rosie-projects/dtmr_tupy/ROS DTMR.png

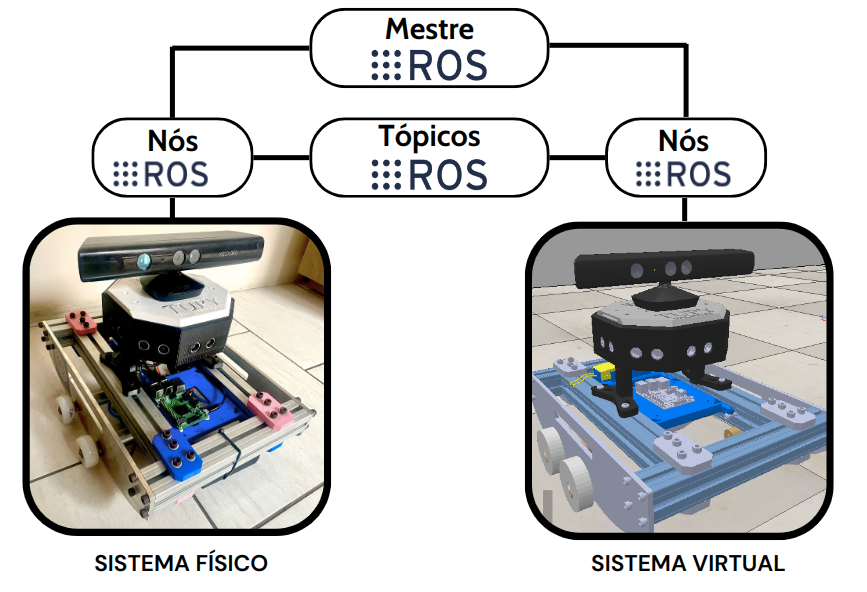
ROS DTMR.png
