rosie-projects/dtmr_tupy/DTMR Tupy.jpeg

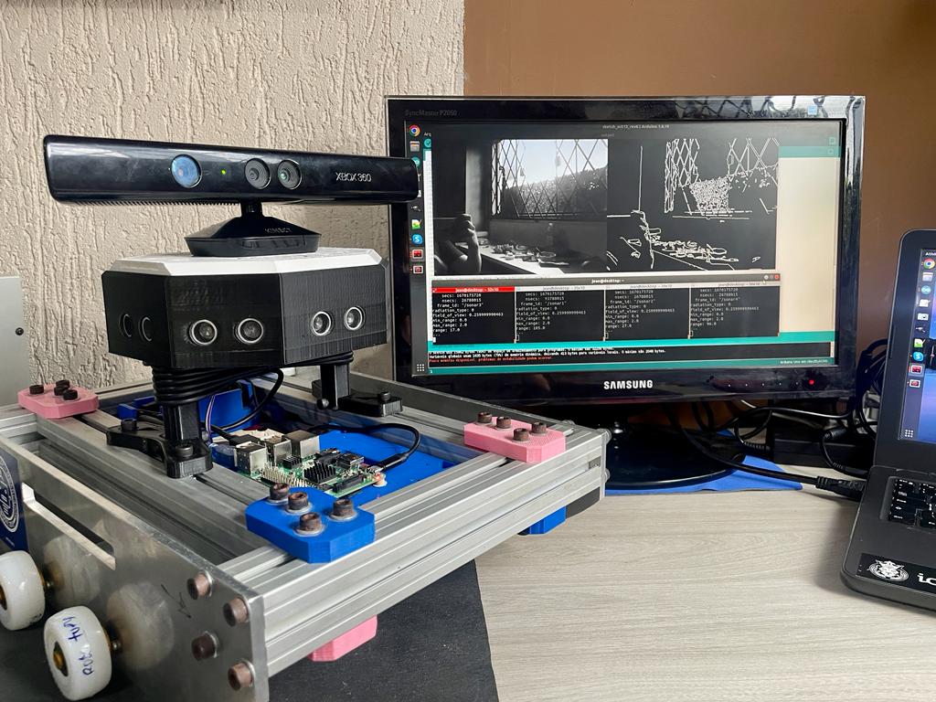
DTMR Tupy.jpeg
