rosie-projects/dtmr_tupy/README.md

# dtmr_tupy 

--Repositório em desenvolvimento.

Validação do conceito Gêmeo Digital na Robótica Móvel - Digital Twin Mobile Robot (DTMR).

Resumo:

Este projeto, derivado da pesquisa acadêmica proposta por Magrin, Del Conte e Todt (2021), tem como objetivo virtualizar o robô Tupy com a finalidade de aprender sistemas ciberfísicos e aplicar conceitos da Indústria 4.0. Utilizando o Sistema Operacional do Robô (ROS) como componente crucial, o projeto Tupy, desenvolvido pelo grupo ROSIE da Universidade de Curitiba (Unicuritiba), serve de base devido à sua capacidade de integração com as plataformas Raspberry Pi (RPi) e Arduino por meio de a estrutura ROS. A implementação bem-sucedida de um Gêmeo Digital de Robô Móvel (DTMR) inclui conquistas como troca de informações entre distintas plataformas de desenvolvimento, integração perfeita do ROS ao robô móvel Tupy e operação e visualização eficazes do robô no simulador robótico CoppeliaSim - EDU.

Abstract:

This project, derived from the academic research proposed by Magrin, Del Conte, and Todt (2021), aims to virtualize the Tupy robot for the purpose of learning cyber-physical systems and applying Industry 4.0 concepts. Utilizing the Robot Operating System (ROS) as a crucial component, the Tupy project, developed by the ROSIE group at the University of Curitiba (Unicuritiba), serves as the foundation due to its integration capabilities with Raspberry Pi (RPi) and Arduino platforms through the ROS framework. The successful implementation of a Digital Twin of Mobile Robot (DTMR) includes achievements such as information exchange between distinct development platforms, seamless integration of ROS into the Tupy mobile robot, and effective operation and visualization of the robot in the CoppeliaSim - EDU robotics simulator.
