rosie-projects/dtmr_tupy/Sistema Físico/Mecânica/Projeto Tupy V1/peça_tampa.SLDPRT

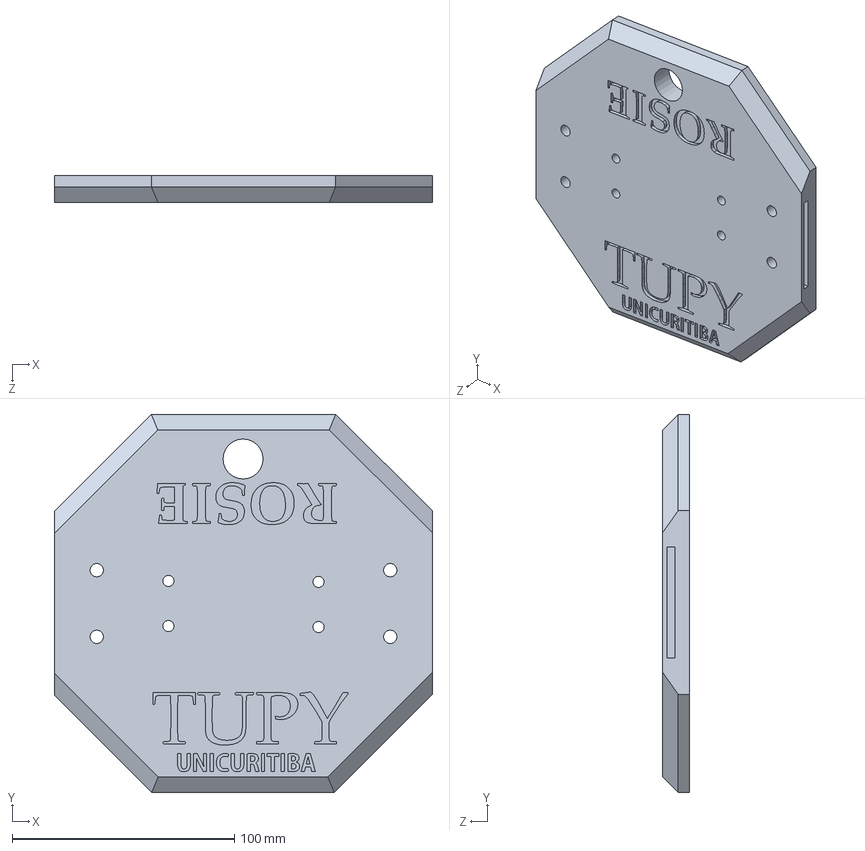
[picture p129: CAD file, 2024-01-31]
Sistema Físico/Mecânica/Projeto Tupy V1/peça_tampa.SLDPRT
170.0 x 170.0 x 12.0 mm
