rosie-projects/dtmr_tupy/Sistema Físico/Mecânica/Projeto Tupy V2 (STEP)/ROSIE-001-03-02.stp

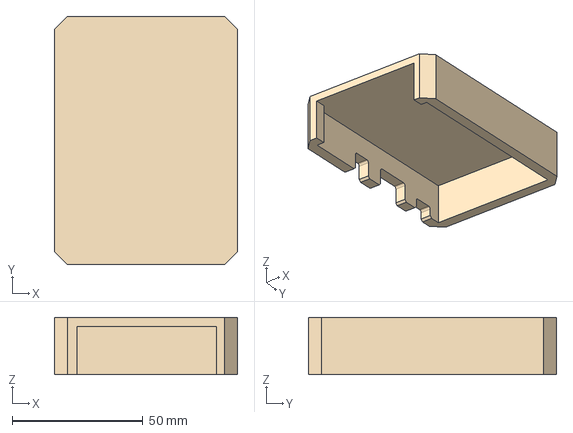
[picture p130: CAD file, 2024-03-12]
Sistema Físico/Mecânica/Projeto Tupy V2 (STEP)/ROSIE-001-03-02.stp
70.0 x 95.0 x 21.9 mm
