rosie-projects/dtmr_tupy/Sistema Físico/Mecânica/Projeto Tupy V1/Pe_SuporteSonar.SLDPRT

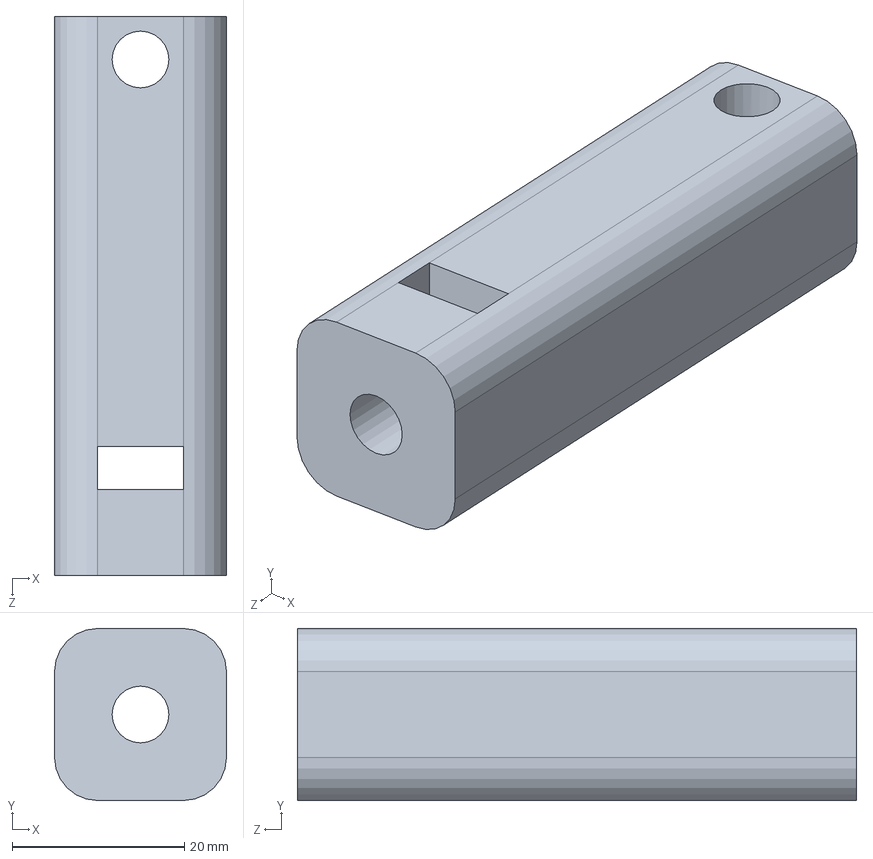
[picture p131: CAD file, 2024-01-31]
Sistema Físico/Mecânica/Projeto Tupy V1/Pe_SuporteSonar.SLDPRT
20.0 x 20.0 x 65.0 mm
