rosie-projects/dtmr_tupy/Sistema Físico/Mecânica/Projeto Tupy V2 (STEP)/ROSIE-001-04-01.stp

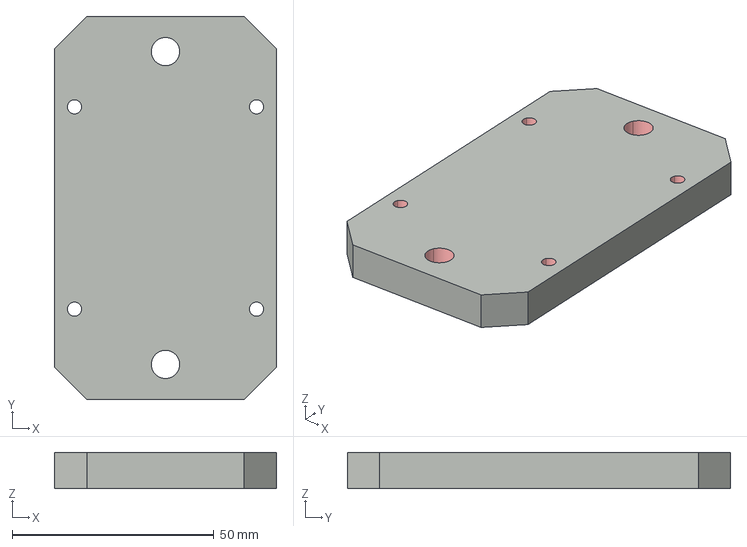
[picture p132: CAD file, 2024-03-12]
Sistema Físico/Mecânica/Projeto Tupy V2 (STEP)/ROSIE-001-04-01.stp
55.0 x 95.0 x 9.00 mm
