rosie-projects/dtmr_tupy/Sistema Físico/Mecânica/Projeto Tupy V1/Peça_base_SuporteSonar.SLDPRT

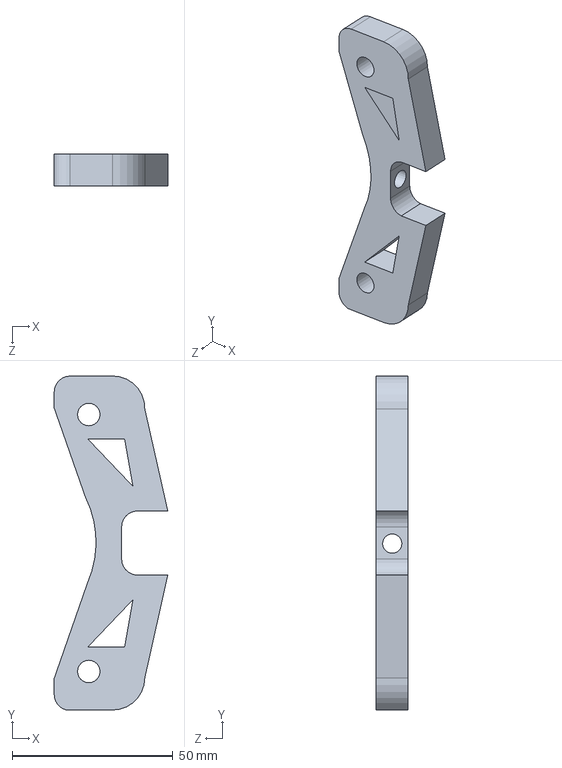
[picture p133: CAD file, 2024-01-31]
Sistema Físico/Mecânica/Projeto Tupy V1/Peça_base_SuporteSonar.SLDPRT
35.4 x 104.0 x 10.0 mm
