rosie-projects/dtmr_tupy/Sistema Físico/Mecânica/Projeto Tupy V2 (STEP)/ROSIE-001-02-01.stp

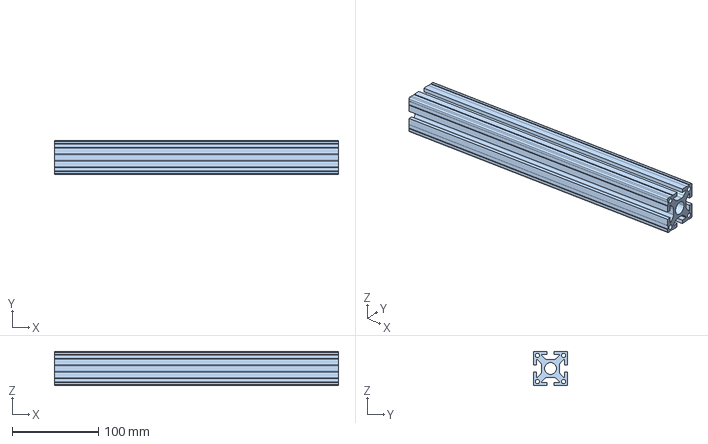
[picture p134: CAD file, 2024-03-12]
Sistema Físico/Mecânica/Projeto Tupy V2 (STEP)/ROSIE-001-02-01.stp
330.0 x 40.0 x 40.0 mm
