rosie-projects/dtmr_tupy/Sistema Físico/Mecânica/Projeto Tupy V1/peçasonares_modificacao.SLDPRT

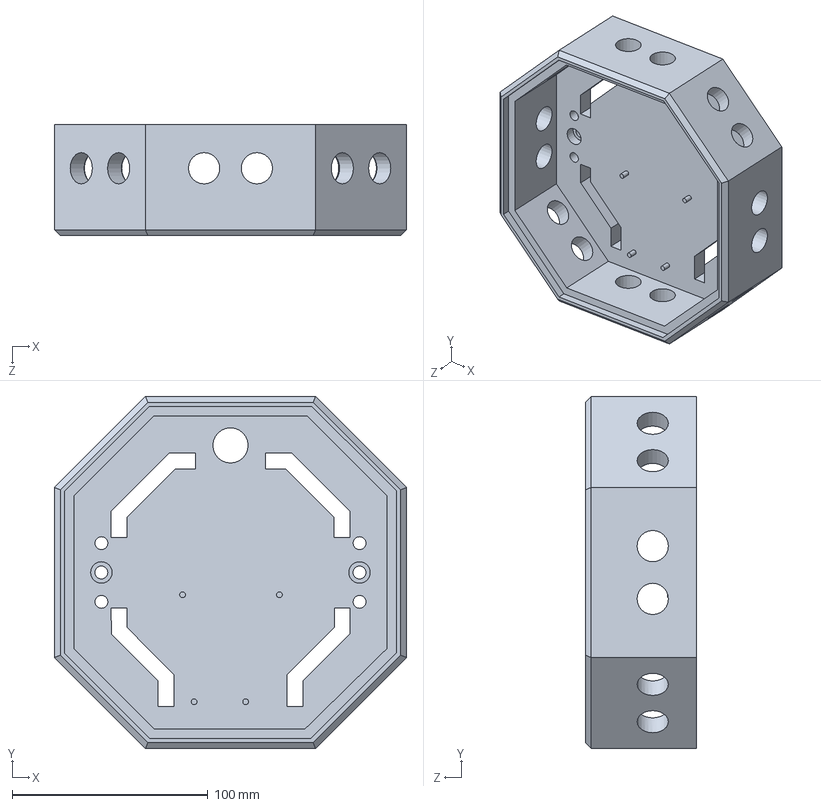
[picture p135: CAD file, 2024-01-31]
Sistema Físico/Mecânica/Projeto Tupy V1/peçasonares_modificacao.SLDPRT
180.0 x 180.0 x 57.0 mm
