rosie-projects/dtmr_tupy/Sistema Físico/Mecânica/Projeto Tupy V2 (STEP)/ROSIE-001-05-03-A.stp

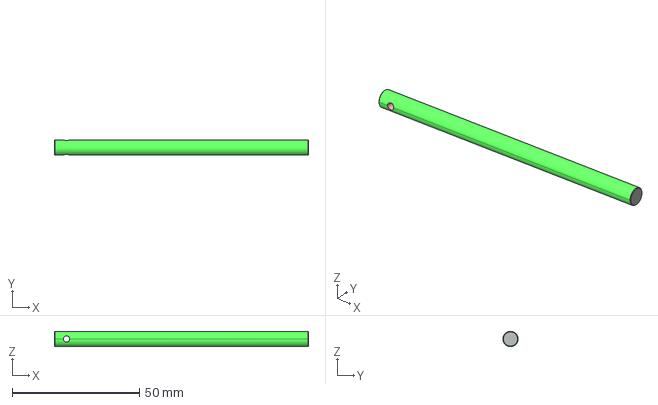
[picture p136: CAD file, 2024-03-12]
Sistema Físico/Mecânica/Projeto Tupy V2 (STEP)/ROSIE-001-05-03-A.stp
100.0 x 6.00 x 6.00 mm
