rosie-projects/dtmr_tupy/Sistema Físico/Mecânica/Projeto Tupy V2 (STEP)/ROSIE-001-05-02.stp

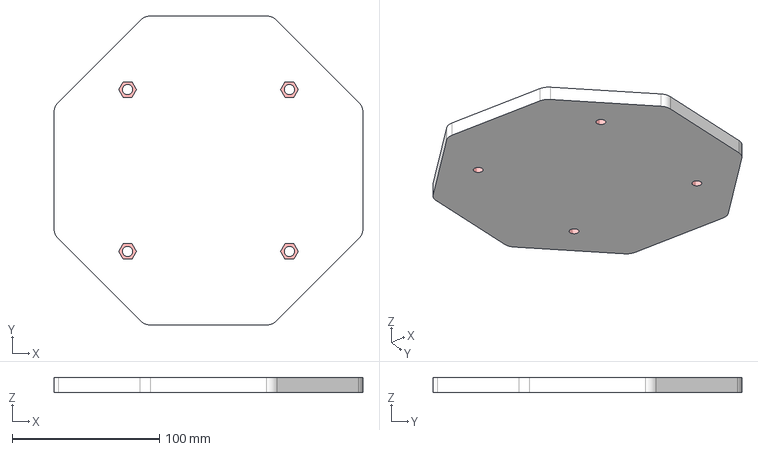
[picture p137: CAD file, 2024-03-12]
Sistema Físico/Mecânica/Projeto Tupy V2 (STEP)/ROSIE-001-05-02.stp
210.0 x 210.0 x 10.0 mm
