rosie-projects/dtmr_tupy/Sistema Físico/Mecânica/Projeto Tupy V2 (STEP)/ROSIE-001-04-00.stp

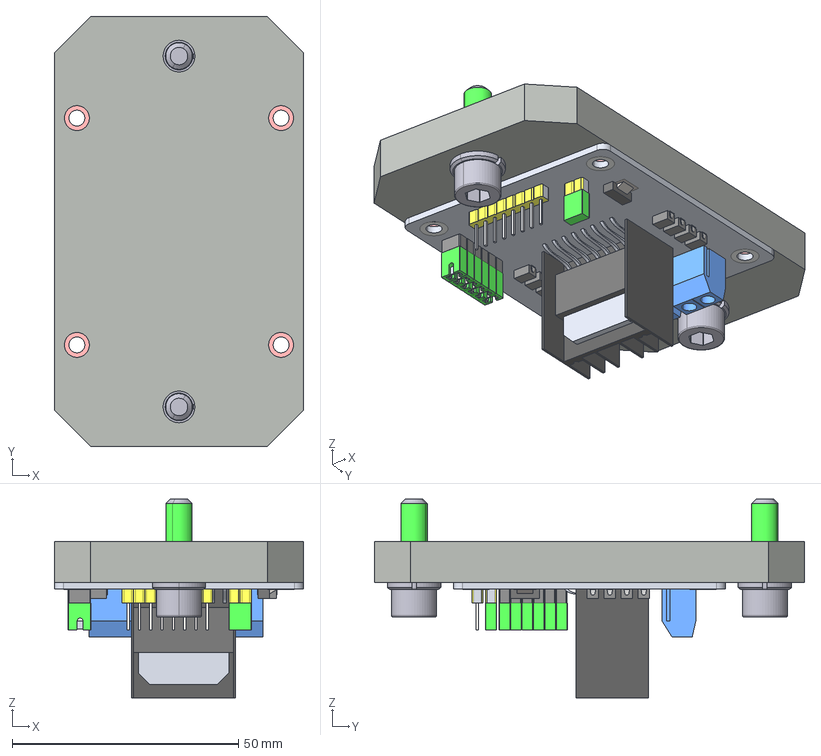
[picture p139: CAD file, 2024-03-12]
Sistema Físico/Mecânica/Projeto Tupy V2 (STEP)/ROSIE-001-04-00.stp
55.0 x 95.0 x 43.9 mm
ROSIE-001-04-01
Ponte H (PRONTO)
DIN 127 - M6 x 2
DIN 912 - M6x20 x 2
