rosie-projects/dtmr_tupy/Sistema Físico/Mecânica/Projeto Tupy V2 (STEP)/ROSIE-001-05-03.stp

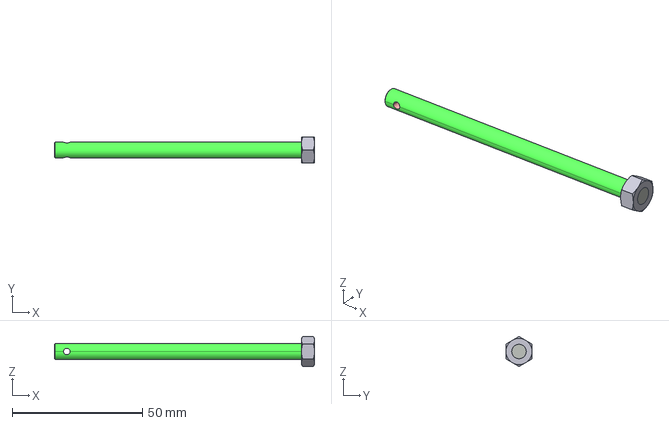
[picture p140: CAD file, 2024-03-12]
Sistema Físico/Mecânica/Projeto Tupy V2 (STEP)/ROSIE-001-05-03.stp
100.0 x 10.0 x 11.5 mm
DIN 934 - M6
ROSIE-001-05-03-A
