rosie-projects/dtmr_tupy/Sistema Físico/Mecânica/Projeto Tupy V2 (STEP)/ROSIE-001-02-00.stp

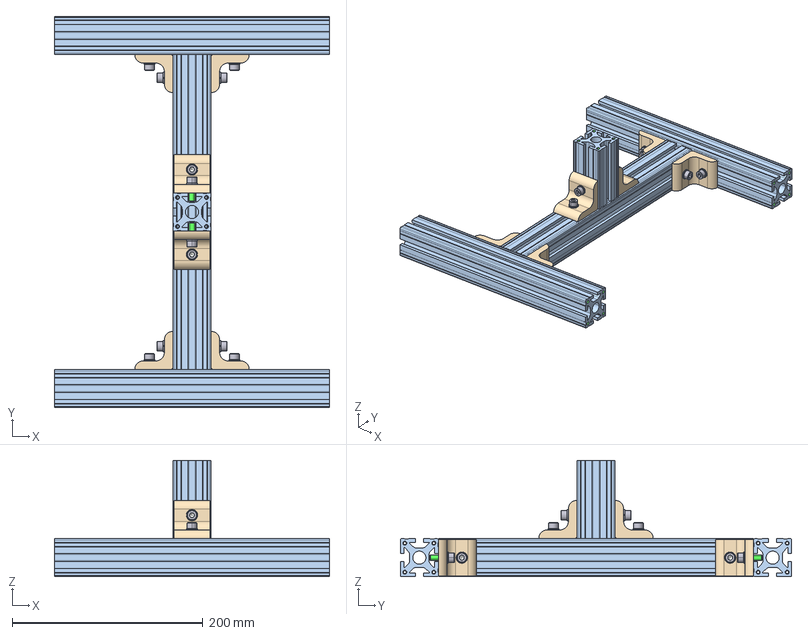
[picture p141: CAD file, 2024-03-12]
Sistema Físico/Mecânica/Projeto Tupy V2 (STEP)/ROSIE-001-02-00.stp
288.0 x 410.0 x 122.0 mm
ROSIE-001-02-01
ROSIE-001-02-02 x 2
ROSIE-001-02-03
ROSIE-001-02-04 x 6
DIN 127 - M6 x 12
DIN 912 - M6x20 x 12
