rosie-projects/dtmr_tupy/Sistema Físico/Mecânica/Projeto Tupy V2 (STEP)/ROSIE-001-06-00.stp

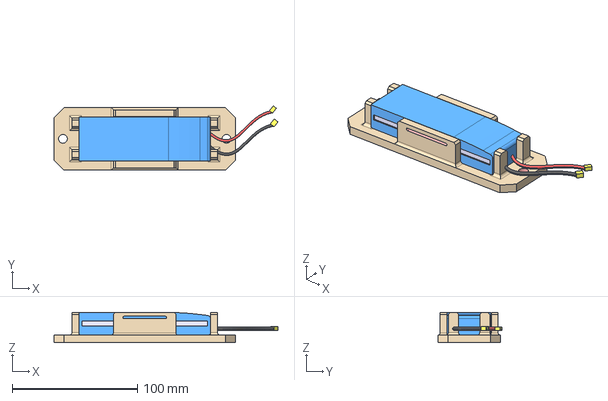
[picture p148: CAD file, 2024-03-12]
Sistema Físico/Mecânica/Projeto Tupy V2 (STEP)/ROSIE-001-06-00.stp
179.0 x 51.4 x 24.0 mm
ROSIE-001-06-01
Bettery Lipo 7.4V 3000mAh
