rosie-projects/dtmr_tupy/Sistema Físico/Mecânica/Projeto Tupy V2 (STEP)/ROSIE-001-01-00.stp

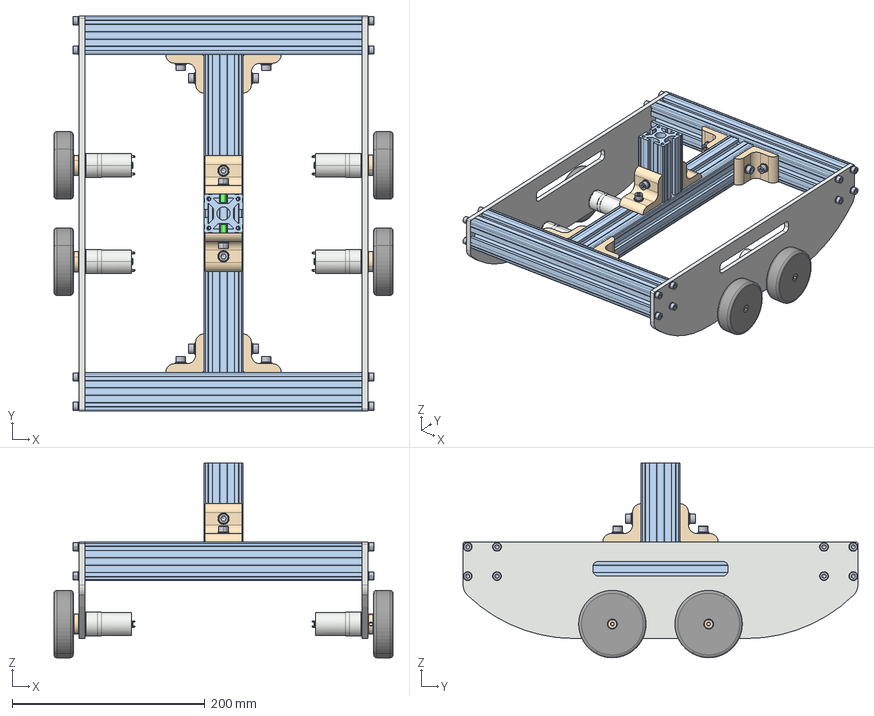
[picture p149: CAD file, 2024-03-12]
Sistema Físico/Mecânica/Projeto Tupy V2 (STEP)/ROSIE-001-01-00.stp
352.0 x 410.0 x 202.0 mm
ROSIE-001-01-01 x 2
ROSIE-001-02-01
ROSIE-001-02-02 x 2
ROSIE-001-02-03
ROSIE-001-02-04 x 6
DIN 127 - M6 x 12
DIN 912 - M6x20 x 12
Hub Eixo Ø6mm Fab. Robocore Cod. NEO V1 x 4
Motor DC 6V Cod. 25GA370-26x x 4
Roda Neoprene Diâ. 70mm x 4
DIN 127 - M5 x 16
DIN 912 - M5x20 x 16
