rosie-projects/dtmr_tupy/(list of files, cad)

Other CAD files:
Sistema Físico/Mecânica/Projeto Tupy V2 (Catia)/10 PORT HEADER.CATPart
Sistema Físico/Mecânica/Projeto Tupy V2 (Catia)/102 RESISTOR PACK.CATPart
Sistema Físico/Mecânica/Projeto Tupy V2 (Catia)/103 RESISTOR PACK.CATPart
Sistema Físico/Mecânica/Projeto Tupy V2 (Catia)/16mhz crystal - measured.CATPart
Sistema Físico/Mecânica/Projeto Tupy V2 (Catia)/220 RESISTOR PACK.CATPart
Sistema Físico/Mecânica/Projeto Tupy V2 (Catia)/2pin_header__02.CATPart
Sistema Físico/Mecânica/Projeto Tupy V2 (Catia)/47uf CAP Dcase.CATPart
Sistema Físico/Mecânica/Projeto Tupy V2 (Catia)/6 PORT HEADER.CATPart
Sistema Físico/Mecânica/Projeto Tupy V2 (Catia)/603 cap on pad.CATPart
Sistema Físico/Mecânica/Projeto Tupy V2 (Catia)/603 resistor.CATPart
Sistema Físico/Mecânica/Projeto Tupy V2 (Catia)/8 PORT HEADER.CATPart
Sistema Físico/Mecânica/Projeto Tupy V2 (Catia)/ATMEL328P.CATPart
Sistema Físico/Mecânica/Projeto Tupy V2 (Catia)/Arduino Uno.CATProduct
Sistema Físico/Mecânica/Projeto Tupy V2 (Catia)/Battery Lipo 7.4V 3000mAh.CATPart
Sistema Físico/Mecânica/Projeto Tupy V2 (Catia)/Component1.CATPart
Sistema Físico/Mecânica/Projeto Tupy V2 (Catia)/Component12.CATPart
Sistema Físico/Mecânica/Projeto Tupy V2 (Catia)/Component13.CATPart
Sistema Físico/Mecânica/Projeto Tupy V2 (Catia)/Component14.CATPart
Sistema Físico/Mecânica/Projeto Tupy V2 (Catia)/Component15.CATPart
Sistema Físico/Mecânica/Projeto Tupy V2 (Catia)/Component16.CATPart
Sistema Físico/Mecânica/Projeto Tupy V2 (Catia)/Component2.CATPart
Sistema Físico/Mecânica/Projeto Tupy V2 (Catia)/Component2_1.CATPart
Sistema Físico/Mecânica/Projeto Tupy V2 (Catia)/Component2_2.CATPart
Sistema Físico/Mecânica/Projeto Tupy V2 (Catia)/Component3.CATPart
Sistema Físico/Mecânica/Projeto Tupy V2 (Catia)/Component3_1.CATPart
Sistema Físico/Mecânica/Projeto Tupy V2 (Catia)/Component4_2.CATPart
Sistema Físico/Mecânica/Projeto Tupy V2 (Catia)/Component4_3.CATPart
Sistema Físico/Mecânica/Projeto Tupy V2 (Catia)/Component5.CATPart
Sistema Físico/Mecânica/Projeto Tupy V2 (Catia)/Component5_1.CATPart
Sistema Físico/Mecânica/Projeto Tupy V2 (Catia)/Component5_2.CATPart
Sistema Físico/Mecânica/Projeto Tupy V2 (Catia)/Component67.CATPart
Sistema Físico/Mecânica/Projeto Tupy V2 (Catia)/Component73.CATPart
Sistema Físico/Mecânica/Projeto Tupy V2 (Catia)/DIN_127_-_M5.CATPart
Sistema Físico/Mecânica/Projeto Tupy V2 (Catia)/DIN_127_-_M6.CATPart
Sistema Físico/Mecânica/Projeto Tupy V2 (Catia)/DIN_912_-_M5x20.CATPart
Sistema Físico/Mecânica/Projeto Tupy V2 (Catia)/DIN_912_-_M6x20.CATPart
Sistema Físico/Mecânica/Projeto Tupy V2 (Catia)/DIN_934_-_M6.CATPart
Sistema Físico/Mecânica/Projeto Tupy V2 (Catia)/Hub Motores.CATPart
Sistema Físico/Mecânica/Projeto Tupy V2 (Catia)/KINECT XBOX.CATPart
Sistema Físico/Mecânica/Projeto Tupy V2 (Catia)/Kinect.CATProduct
Sistema Físico/Mecânica/Projeto Tupy V2 (Catia)/MLC0603.CATPart
Sistema Físico/Mecânica/Projeto Tupy V2 (Catia)/MOTOR-25GA370.CATPart
Sistema Físico/Mecânica/Projeto Tupy V2 (Catia)/Manipulo Femea Vazado M6.CATPart
Sistema Físico/Mecânica/Projeto Tupy V2 (Catia)/PADS001.CATPart
Sistema Físico/Mecânica/Projeto Tupy V2 (Catia)/RESET CORE.CATPart
Sistema Físico/Mecânica/Projeto Tupy V2 (Catia)/RESET.CATPart
Sistema Físico/Mecânica/Projeto Tupy V2 (Catia)/ROSIE-001-00-00.CATProduct
Sistema Físico/Mecânica/Projeto Tupy V2 (Catia)/ROSIE-001-01-00.CATProduct
Sistema Físico/Mecânica/Projeto Tupy V2 (Catia)/ROSIE-001-01-01.CATPart
Sistema Físico/Mecânica/Projeto Tupy V2 (Catia)/ROSIE-001-02-00.CATProduct
Sistema Físico/Mecânica/Projeto Tupy V2 (Catia)/ROSIE-001-02-01.CATPart
Sistema Físico/Mecânica/Projeto Tupy V2 (Catia)/ROSIE-001-02-02.CATPart
Sistema Físico/Mecânica/Projeto Tupy V2 (Catia)/ROSIE-001-02-04.CATPart
Sistema Físico/Mecânica/Projeto Tupy V2 (Catia)/ROSIE-001-02-05.CATPart
Sistema Físico/Mecânica/Projeto Tupy V2 (Catia)/ROSIE-001-03-00.CATProduct
Sistema Físico/Mecânica/Projeto Tupy V2 (Catia)/ROSIE-001-03-01.CATPart
Sistema Físico/Mecânica/Projeto Tupy V2 (Catia)/ROSIE-001-03-02.CATPart
Sistema Físico/Mecânica/Projeto Tupy V2 (Catia)/ROSIE-001-04-00.CATProduct
Sistema Físico/Mecânica/Projeto Tupy V2 (Catia)/ROSIE-001-04-01.CATPart
Sistema Físico/Mecânica/Projeto Tupy V2 (Catia)/ROSIE-001-05-00.CATProduct
Sistema Físico/Mecânica/Projeto Tupy V2 (Catia)/ROSIE-001-05-01.CATPart
Sistema Físico/Mecânica/Projeto Tupy V2 (Catia)/ROSIE-001-05-02.CATPart
Sistema Físico/Mecânica/Projeto Tupy V2 (Catia)/ROSIE-001-05-03-A.CATPart
Sistema Físico/Mecânica/Projeto Tupy V2 (Catia)/ROSIE-001-05-03.CATProduct
Sistema Físico/Mecânica/Projeto Tupy V2 (Catia)/ROSIE-001-06-00.CATProduct
Sistema Físico/Mecânica/Projeto Tupy V2 (Catia)/ROSIE-001-06-01.CATPart
Sistema Físico/Mecânica/Projeto Tupy V2 (Catia)/Raspberry PI 3 Plus.CATProduct
Sistema Físico/Mecânica/Projeto Tupy V2 (Catia)/Roda Neoprene Dia. 70mm.CATPart
Sistema Físico/Mecânica/Projeto Tupy V2 (Catia)/SONAR.CATPart
Sistema Físico/Mecânica/Projeto Tupy V2 (Catia)/SOP-3 2.5mm.CATPart
Sistema Físico/Mecânica/Projeto Tupy V2 (Catia)/SOP-3.CATPart
Sistema Físico/Mecânica/Projeto Tupy V2 (Catia)/SOP-3_1.6mm.CATPart
Sistema Físico/Mecânica/Projeto Tupy V2 (Catia)/TS10008.CATPart
Sistema Físico/Mecânica/Projeto Tupy V2 (Catia)/TSOP-2 4mm.CATPart
Sistema Físico/Mecânica/Projeto Tupy V2 (Catia)/TSOP-6 2mm.CATPart
Sistema Físico/Mecânica/Projeto Tupy V2 (Catia)/TSOP-6 3mm.CATPart
Sistema Físico/Mecânica/Projeto Tupy V2 (Catia)/USB SHELL.CATPart
Sistema Físico/Mecânica/Projeto Tupy V2 (Catia)/USB core.CATPart
Sistema Físico/Mecânica/Projeto Tupy V2 (Catia)/atmega16u2.CATPart
Sistema Físico/Mecânica/Projeto Tupy V2 (Catia)/back_shell.CATPart
Sistema Físico/Mecânica/Projeto Tupy V2 (Catia)/base KINECT.CATPart
Sistema Físico/Mecânica/Projeto Tupy V2 (Catia)/base.CATPart
Sistema Físico/Mecânica/Projeto Tupy V2 (Catia)/base_1.CATPart
Sistema Físico/Mecânica/Projeto Tupy V2 (Catia)/bcm2837.CATPart
Sistema Físico/Mecânica/Projeto Tupy V2 (Catia)/blm21.CATPart
Sistema Físico/Mecânica/Projeto Tupy V2 (Catia)/bottom_lead.CATPart
Sistema Físico/Mecânica/Projeto Tupy V2 (Catia)/cap0402.CATPart
Sistema Físico/Mecânica/Projeto Tupy V2 (Catia)/cap0603_03.CATPart
Sistema Físico/Mecânica/Projeto Tupy V2 (Catia)/cap1206.CATPart
Sistema Físico/Mecânica/Projeto Tupy V2 (Catia)/capar2_1013.CATPart
Sistema Físico/Mecânica/Projeto Tupy V2 (Catia)/cd1206 diode.CATPart
Sistema Físico/Mecânica/Projeto Tupy V2 (Catia)/crystal.CATPart
Sistema Físico/Mecânica/Projeto Tupy V2 (Catia)/dip socket pin.CATPart
Sistema Físico/Mecânica/Projeto Tupy V2 (Catia)/dip28_1.CATPart
Sistema Físico/Mecânica/Projeto Tupy V2 (Catia)/ind2520.CATPart
Sistema Físico/Mecânica/Projeto Tupy V2 (Catia)/lead.CATPart
Sistema Físico/Mecânica/Projeto Tupy V2 (Catia)/leads_3.CATPart
Sistema Físico/Mecânica/Projeto Tupy V2 (Catia)/led.CATPart
Sistema Físico/Mecânica/Projeto Tupy V2 (Catia)/led_org.CATPart
Sistema Físico/Mecânica/Projeto Tupy V2 (Catia)/ledra_0603.CATPart
Sistema Físico/Mecânica/Projeto Tupy V2 (Catia)/lights_1.CATPart
Sistema Físico/Mecânica/Projeto Tupy V2 (Catia)/lmv358.CATPart
Sistema Físico/Mecânica/Projeto Tupy V2 (Catia)/lp2985dgkr.CATPart
Sistema Físico/Mecânica/Projeto Tupy V2 (Catia)/m7 diode.CATPart
Sistema Físico/Mecânica/Projeto Tupy V2 (Catia)/magnetics.CATPart
Sistema Físico/Mecânica/Projeto Tupy V2 (Catia)/mf-msmf050-2.CATPart
Sistema Físico/Mecânica/Projeto Tupy V2 (Catia)/mid_cover.CATPart
Sistema Físico/Mecânica/Projeto Tupy V2 (Catia)/molex hdmi smt_1.CATPart
Sistema Físico/Mecânica/Projeto Tupy V2 (Catia)/nano - reg.CATPart
Sistema Físico/Mecânica/Projeto Tupy V2 (Catia)/outer.CATPart
Sistema Físico/Mecânica/Projeto Tupy V2 (Catia)/pcb.CATPart
Sistema Físico/Mecânica/Projeto Tupy V2 (Catia)/pins.CATPart
Sistema Físico/Mecânica/Projeto Tupy V2 (Catia)/pins_1.CATPart
Sistema Físico/Mecânica/Projeto Tupy V2 (Catia)/pj-322_1.CATPart
Sistema Físico/Mecânica/Projeto Tupy V2 (Catia)/power jack.CATPart
Sistema Físico/Mecânica/Projeto Tupy V2 (Catia)/qfn32_5mm.CATPart
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
