rosie-projects/dtmr_tupy/Manual Básico DTMR.pdf

se roscore no terminal para iniciar a interface (Figura 108).

sendo que só pode ser executado em uma das estações via terminal. Logo, digitaum ROS MASTER. Sem iniciá-lo, fica impossível estabelecer uma conexão ROS,

Este comando é utilizado para criar uma conexão entre os nós, definindo

4.1.1.1 Roscore

MASTER.

biente do framework ROS. Primeiramente, é definido que o desktop será o ROS

Finalizado as etapas de integração (hardware e software), inicia-se o am-

### 4.1.1 Ambiente ROS

Sim.

ultrassônicos, bem como, conceber o DT, através da plataforma virtual Coppeliatrole da movimentação, as imagens geradas pelo Kinect no desktop, os sensores ente ciber-físico. Dessa forma, será possível verificar questões pertinentes ao con-

Esta seção consiste em realizar a validação da aplicação do DTMR no ambi-

4.1 VALIDAÇÃO DO DTMR TUPY

4.0, CPS, robótica móvel e DT.

pertinentes ao desenvolvimento deste projeto, embasado nos conceitos de Indústria

Este capítulo visa validar a proposta DTMR, verificando os resultados obtidos

Digital na Robótica Móvel)

sistemas Ciber Físicos: Uma aplicação inserida no conceito de Gêmeo

### 4 VALIDAÇÃO (Capítulo extraído do TCC - Ferramenta para aprendizagem de

Figura 108: Iniciando Roscore no Terminal desktop.


Fonte: O Autor (2022).

4.1.1.2 Arduino

Após iniciar o roscore, deve-se realizar o login no robô Tupy via SSH. Inicia-se o procedimento para configuração da rosserial-arduino. Primeiramente, deve-se habilitar a interface USB, geralmente denominada ACM*. Essa configuração deve ser realizada, pois, devido à segurança do Linux, deve-se habilitar essa porta para estabelecer a comunicação com dispositivos externos. Então, os comandos da Figura 109 foram inseridos no terminal para realizar essa parametrização.

Figura 109: Configurando Rosserial-Arduino no Terminal.


Fonte: O Autor (2022).

Após a conexão estabelecida do desktop com o robô Tupy, basta executar o comando:

- export ROS_MASTER_URI=http://192.168.15.21:11311
- export ROS_IP=192.168.15.22
- rosrun rosserial_python serial_node.py /dev/ttyACM0

Como boas práticas de integração com o ROS, é sempre recomendado que seja exportado em qual dispositivo o ROS MASTER está sendo executado e o Internet Protocol – Protocolo de Internet (IP) do dispositivo atual. Esses códigos devem ser utilizados toda vez que alguma aplicação relacionada ao ROS for iniciada. No caso, o MASTER é o desktop, já o ROS IP pertence ao robô Tupy.
Em seguida, é possível notar que o comando rosrun cria o ROS Serial Python NODE. Dessa forma, o ROS executa o script da conexão serial do Arduino na porta ttyACM0, publicando os Tópicos dos sonares (1, 2, 3 e 4) e inscrevendo as mensagens do cmd_vel, conforme Figura 110.

Figura 110: Iniciando Rosserial-Arduino no Terminal.


Fonte: O Autor (2022).

Para verificar se o ROS está identificando os Tópicos ativos, o comando rostopic list pode ser digitado para verificar essa informação, conforme Figura 108.

Figura 111: Rostopic List.


Fonte: O Autor (2022).

A partir de então, utilizado a função echo, pode-se “ouvir” as informações que estão em cada tópico. Então, digitam-se os seguintes comandos em terminais separados:

- rostopic echo /sonar1
- rostopic echo /sonar2
- rostopic echo /sonar3
- rostopic echo /sonar4

Com isso, tem-se a visualização dos Tópicos (Figura 112) das distâncias lidas pelos sensores ultrassônicos, conforme programação do Arduino.

Figura 112: Echo 4 Sonares.


Fonte: O Autor (2022).

4.1.1.3 Teleoperação

Aqui será implementado o controle do robô físico e virtual simultaneamente com o uso do cmd_vel. Para iniciar a interface deve digitar-se as seguintes linhas de comando no terminal:

- export ROS_MASTER_URI=http://192.168.15.21:11311
- export ROS_IP=192.168.15.22
- rosrun teleop_twist_keyboard teleop_twist_keyboard.py

Como as interfaces de inscrição deste foi iniciada anteriormente, o pacote então publica as mensagens vetoriais conforme a Figura 113.

Figura 113: Iniciando Teleoperação.


Fonte: O Autor (2022).

A partir de então, conforme a captura das teclas, o robô é movimentado com velocidades linear e angular definidas.

4.1.1.4 Kinect e OpenCV

Após a compilação dos drivers freenect, inicia-se com o roslaunch a publicação dos Tópicos da câmera do Kinect, conforme os seguintes comandos:

- ROS_MASTER_URI=http://192.168.15.21:11311
- ROS_IP=192.168.15.22
- roslaunch freenect_launch freenect.launch

Figura 114: Iniciando Pacote Freenect.


Fonte: O Autor (2022).

Nota-se, que os Tópicos estão prontos para serem inscritos. Então, inicia-se o pacote Canny Kinect, com os seguintes comandos no terminal:

- export ROS_MASTER_URI=http://192.168.15.21:11311
- export ROS_IP=192.168.15.22
- rosrun img_processor csf_robotCS_cannyKinect.py

Com tudo certo, é retornado uma tela de visualização em tempo real com imagens em escala de cinza e com o rastreio das arestas, como se observa na Figura 115.

Figura 115: Canny Kinect em execução.


Fonte: O Autor (2022).

### 4.1.2 Visualizando pacotes do ROS com RviZ e rtq_graph

A grande vantagem do uso do RviZ, é a facilidade da visualização de Tópicos ativos no ROS. Esta ferramenta é fundamental para a realização de testes durante o desenvolvimento no ambiente ROS, pois pode-se verificar que a comunicação entre os Nós do ROS está correta e se os drivers do Kinect foram iniciados corretamente. A Figura 116, demonstra através do detalhe (2) algumas destas opções disponíveis para criação. Já o detalhe (1), é possível visualizar a saída do tópico infravermelho do Kinect criado.

- export ROS_MASTER_URI=http://192.168.15.21:11311
- export ROS_IP=192.168.15.22
- rviz

Figura 116: Visualizando o Tópico infravermelho da câmera.


Fonte: O Autor (2022).

Outra maneira de visualizar os tópicos ativos, é utilizar a ferramenta gráfica nativa do ROS rtq_graph, conforme Figura 117.

Figura 117: Arquitetura dos tópicos do robô Tupy com rtq_graph.


Fonte: O Autor (2022).

É possível notar (Figura 117) que o driver Freenect inicia vários Tópicos re-

ferentes a câmera. Porém, apenas o Tópico /camera/rgb é necessário para o funcionamento do pacote Canny. Já o teleop_twist_keyboard realiza o envio de mensagens geométricas através do tópico cmd_vel para as interfaces de simulação virtual (sim_ros_interface) e o robô Tupy físico através do Nó serial_node que, também, faz a gestão dos tópicos referentes aos sensores ultrassônicos (sonares), publicando mensagens de distância (Range). Dessa forma tem-se o DT arquitetado pelo framework ROS.

### 4.1.3 Resumo da inicialização dos serviços do Gêmeo Digital

Portanto, em suma, o Tupy foi iniciado na sequência dos comandos inseridos no terminal do desktop, conforme ordem a seguir:

- No terminal 1, inicia-se o ROS Master:

– jean@desktop: $ roscore

- No terminal 2, inicia-se o Freenect Driver:

– jean@desktop: $ ssh tupy@192.168.15.22

– tupy@tupy-robot: $ export ROS_MASTER_URI=http://192.168.15.21:11311

– tupy@tupy-robot: $ export ROS_IP=192.168.15.22

– tupy@tupy-robot: $ roslaunch freenect_launch freenect.launch

- No terminal 3, inicia-se a comunicação serial do Arduino:

– jean@desktop: $ ssh tupy@192.168.15.22

– tupy@tupy-robot: $ export ROS_MASTER_URI=http://192.168.15.21:11311

– tupy@tupy-robot: $ export ROS_IP=192.168.15.22

– tupy@tupy-robot: $ rosrun rosserial_python serial_node.py /dev/ttyACM0

- No terminal 4, inicia-se a leitura do primeiro sensor ultrassônico:

– jean@desktop: $ export ROS_MASTER_URI=http://192.168.15.21:11311

– jean@desktop: $ export ROS_IP=192.168.15.21

– jean@desktop: $ rostopic echo /sonar1

- No terminal 5, inicia-se a leitura do segundo sensor ultrassônico:

– jean@desktop: $ export ROS_MASTER_URI=http://192.168.15.21:11311

– jean@desktop: $ export ROS_IP=192.168.15.21

– jean@desktop: $ rostopic echo /sonar2

- No terminal 6, inicia-se a leitura do terceiro sensor ultrassônico:

– jean@desktop: $ export ROS_MASTER_URI=http://192.168.15.21:11311

– jean@desktop: $ export ROS_IP=192.168.15.21

– jean@desktop: $ rostopic echo /sonar3

- No terminal 7, inicia-se a leitura do quarto sensor ultrassônico:

– jean@desktop: $ export ROS_MASTER_URI=http://192.168.15.21:11311

– jean@desktop: $ export ROS_IP=192.168.15.21

– jean@desktop: $ rostopic echo /sonar4

- No terminal 8, inicia-se a execução do pacote Canny:

– jean@desktop: $ export ROS_MASTER_URI=http://192.168.15.21:11311

– jean@desktop: $ export ROS_IP=192.168.15.21

– jean@desktop: $ rosrun img_processor csf_robotCS_cannyKinect.py

- No terminal 9, inicia-se a teleoperação com pacote Twist:

– jean@desktop: $ export ROS_MASTER_URI=http://192.168.15.21:11311

– jean@desktop: $ export ROS_IP=192.168.15.21

– jean@desktop: $ rosrun teleop_twist_keyboard teleop_twist_keyboard.py

- No terminal 10, inicia-se o ambiente virtual do CoppeliaSim:

– jean@desktop: $ export ROS_MASTER_URI=http://192.168.15.21:11311

– jean@desktop: $ export ROS_IP=192.168.15.21

– jean@desktop: $ coppelia

### 4.1.4 Tupy no ambiente ciber-físico como gêmeo digital

Finalizando todas as etapas demonstradas, parte-se para a inicialização do cenário virtual no CoppeliaSim, então abre-se o cenário com a modelagem do robô Tupy e inicia-se a simulação. Com isso, tem-se o DTMR Tupy no ambiente ciber, conforme Figura 118.

Figura 118: Tupy no ambiente CoppeliaSim.


Fonte: O Autor (2022).

Então, a partir do momento em que comandos são inseridos no terminal da teleoperação, o robô virtual e físico passam a se movimentar, com o pacote da câmera, gera imagens do ambiente e, por fim, através da comunicação serial com o Arduino, medir as distâncias dos obstáculos com as mensagens de distâncias enviadas pela leitura dos sensores ultrassônicos, conforme a Figura 119, do robô Tupy no ambiente real. Portanto, através deste desenvolvimento, tem-se o Gêmeo Digital, aplicados à robótica móvel DTMR.

Figura 119: Tupy no ambiente Real.


Fonte: O Autor (2022).
