rosie-projects/dtmr_tupy/Sistema Físico/Elétrica/SCH_TCC_Tupy_Unicuritiba_2022.PDF

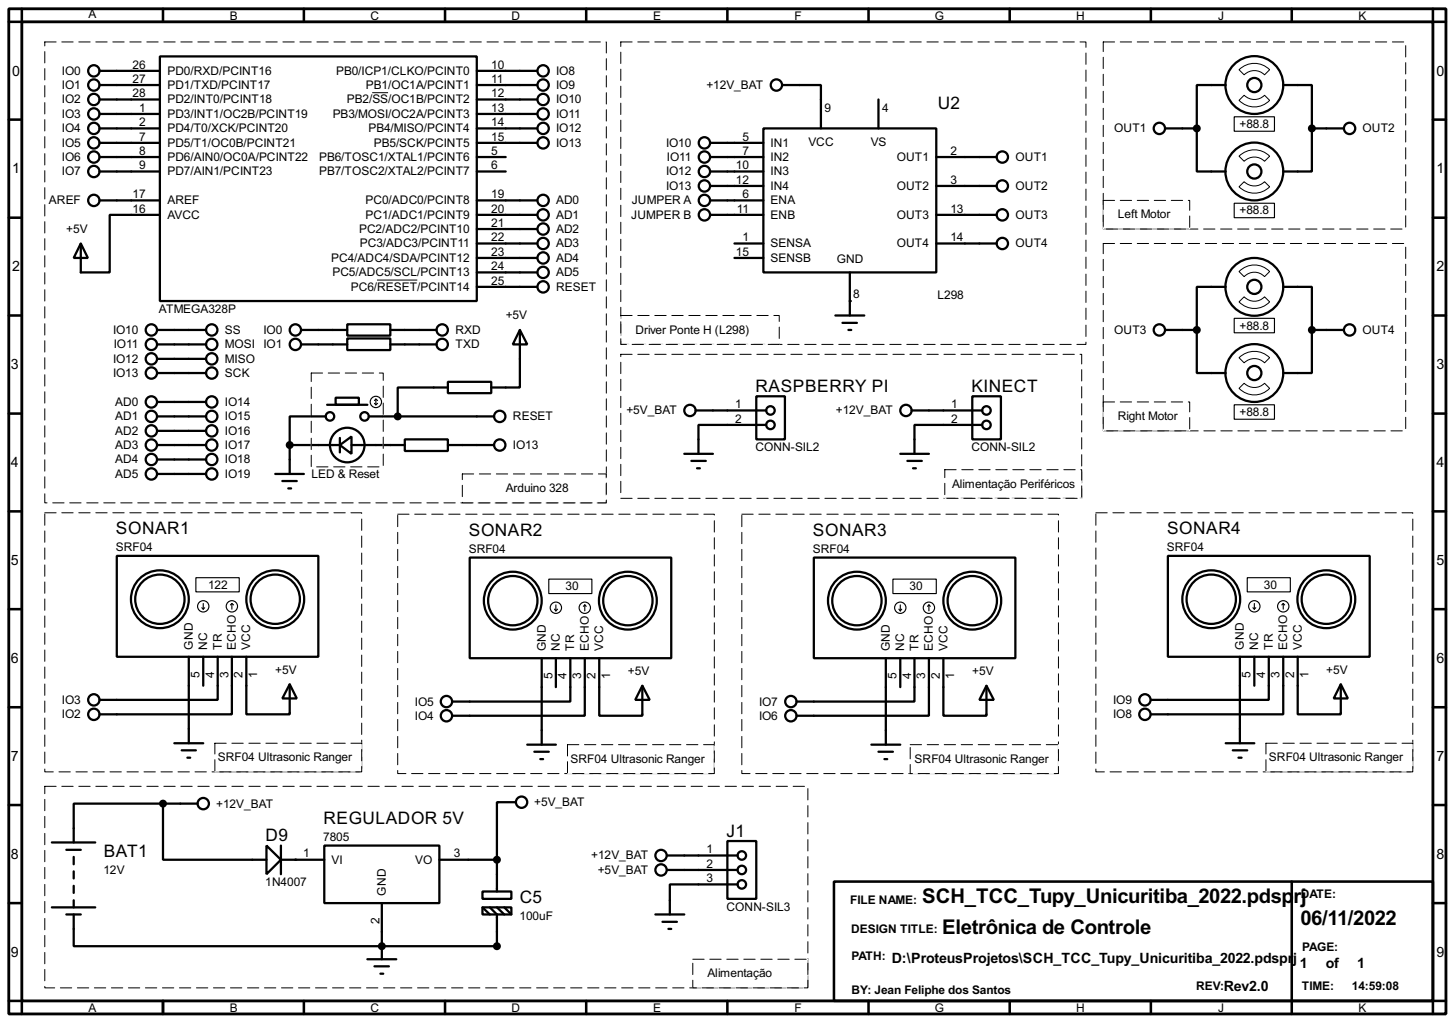
[picture p150: page 1]

FILE NAME:
DESIGN TITLE: Eletrônica de Controle

Jean Feliphe dos Santos
